knsalvador/CMSC190_KANSalvador/INSTALL.md

# Installation
The apk file under the CMSC190_KANSalvador/code directory can be directly downloaded and installed on any android phone.

# Development Set-up
Include instructions how to setup development environment and include any prerequisites.
1. Arduino IDE 1.8.12 or higher and the following libraries:
  - Adafruit_NeoPixel.h
  - OneWire.h
  - DallasTemperature.h
  - SoftwareSerial.h
  - FirebaseESP8266.h
  - ESP8266WiFi.h
  - SoftwareSerial.h

2. Android Studio 3.6.2 or higher

3. Google Firebase Realtime Database
