knsalvador/CMSC190_KANSalvador/presentation/CMSC190_KANSalvador_journal.pdf

CMSC 190 SPECIAL PROBLEM, INSTITUTE OF COMPUTER SCIENCE | 1

# Nemo: An Arduino Aquarium Monitoring System Controlled by An Android Mobile Application

Katrina Anne N. Salvador and Prof. Jaime M. Samaniego

Abstract—The growing popularity of mobile applications comes from its ability to assist in a wide range of tasks and its portability. This study aims to create an aquarium monitoring system that is manageable, cost-efficient, and relevant. This study utilizes the customizability of Arduino microcontrollers, along with compatible sensors, to measure water temperature, water pH, and water turbidity. A mobile application is created to alert the user when the condition of the aquarium is not ideal, display the data from the sensors that are retrieved from a Firebase realtime database where the data is uploaded by the Arduino, and allow the user to control the aquarium’s lighting supply.

I. INTRODUCTION
A. Background of the Study

The evolution of the basic mobile phone into smartphones that offer extensive capabilities and features made way to the first mobile applications. More specifically, the release of Apple’s first iPhone in 2007 worked up the acceleration of mobile applications that they boast as a new service type that meet the needs of users - ”Whatever you want to do, there is an app for it”. [15] From being used only for calling and texting, mobile phones have progressed into tools that support a wide variety of tasks such as music and movie streaming, online multiplayer gaming, navigating, travelling, reading news, etc. [2] These mobile applications have different kinds of users, some are large industries that take advantage of these capabilities and incorporate mobile apps into their businesses, and some people use these mobile applications personally for their own hobbies such as stargazing, gardening, and maintaining an aquarium.
Understanding what happens inside your aquarium is important in ensuring that aquatic life remains healthy. In maintaining an aquarium, monitoring is usually done manually. A human may commit errors due to nature. Gathering data about the aquarium’s current state must be done regularly and the user must be immediately alerted when problems arise [9]. Drastic changes in the levels of water parameter values affect the life of aquatic animals. With the help of sensors and wireless technology, a system that is simple but is effective in terms of minimizing overall human work and error, would provide great assistance.
B. Statement of the Problem

Most elements dissolve in water and it becomes hard to determine the amount of material mixed in it. Checking the quality of water requires accuracy and hard work. It has become necessary to involve technology to produce a quick result from an efficient method to determine the quality of water [13].
Fish are usually delicate to changes in its surroundings and pollution or conditions that are not suitable for fishkeeping may lead to a high mortality rate.
Currently, there are already several existing aquarium monitoring systems available on the market and over the internet such as, multifunctional aquariums which have built-in controllers that are able to adjust water level, temperature level, oxygen level, etc., or other mobile applications, but these can be very complex and expensive [6].
C. Objectives of the Study

This study aims to create an Android application and an Arduino-based system that will be able to digitally monitor a freshwater aquarium using sensors and actuators. More specifically, the proposed application aims to perform the following:
A) To obtain data regarding the aquarium’s current condition using sensors;
B) To be able to switch the aquarium LED using the application over WiFi;
C) To be able to display the aquarium’s current conditions on a mobile application; and
D) To be able to notify the user regarding unacceptable changes in the aquarium’s condition.
D. Scopes and Limitations of the Study

This study will be limited to small-scale home freshwater aquariums containing common tropical fish. The parameters that will be measured are:
A) Water temperature
B) Water pH
C) Water turbidity
The aquarium component that will use an actuator is:
A) LED
The mobile application was developed by the researcher herself and will not be uploaded to the Google Play Store. The accuracy of the data is dependent on the specifications of each sensor.
Arduino clones will be used for prototyping.
Due to the ongoing quarantines caused by the COVID-19 pandemic, an actual aquarium is not available for testing which involves physical contact. Instead, a 500ml sample of water from the aquarium is obtained for testing.

E. Significance of the Study

With the evolution of technology, more and more tasks become easier to complete because almost everything can be done with the help of mobile applications.
With the use of a mobile application and an internet connection, a user will be able to know the current state of his/her aquarium without personally assessing and measuring the water’s condition. When this system is implemented on a large scale, it may be used in monitoring the water quality of fish farms.

II. REVIEW OF RELATED LITERATURE

A. Ideal Aquarium Condition Parameters

For a freshwater aquarium, the ideal measurement of water temperature falls within the range of 22.22-27.77◦C and the ideal level of water pH falls within the range of 6.5-7.5 [7]. Most, but not all, species of tropical or freshwater fish can thrive on the mentioned pH levels. This is the reason behind why some fish are usually kept separate in different tanks with different pH levels. The safe turbidity level for long-term exposure is up to 3 NTU and fish begin to show signs of stress at 10 NTU. [11]
It is vital to monitor the temperature of your aquarium’s water. For tropical fish, heat is necessary during the colder months of the year. Many aquarists living in places with temperate climates face the opposite problem during summer, which is, keeping the aquarium from overheating [8].
As the water’s pH increases, so does the ammonia percentage. Ammonia is toxic and at high pH levels, it limits an organism’s ability to purge itself of waste. Keeping your aquarium pH stable not only reduces stress on the fish, helps them resist disease and tolerate stressors but can also dramatically improve growth, behavior, and overall appearance [3].
Another measure of water quality is turbidity. It is the cloudiness or haziness of a fluid caused by a multiplicity of individual particles that are generally invisible to the naked eye, similar to smoke in air. It is basically an optical determination of water clarity. Turbidites may appear in the form of milky-gray water or as a greenish stain in the water. Milky or green stains indicate an algal or bacterial bloom. This phenomenon can happen quite suddenly and be caused by fluctuations in seasons [16].
The species that inhabit aquariums will be impacted in varying degrees by a constant level of light. To mimic the light available in a species’ habitat, aquarium owners can use day and night lighting to approximate the light levels in a natural environment. These night lights, or Moon Lights, as they are called, give the fish keeper the opportunity to observe nocturnal behavior. [17] Bright light also helps enrich the color of the fish. Bright light helps darken the pigments of many fish, making them stand out.
Lighting is a major part of having a visually pleasing community aquarium. The right lighting is very beneficial to aquatic plant life and therefore, to the fish and aquatic creatures in the aquarium as well.
B. Internet of Things and Wireless Sensor Networks
The Internet of Things or what is more commonly known as IoT involves a network of physical devices embedded with electronics, sensors, and actuators which can collect, connect and exchange data with each other. Lately there has been considerable growth in the development of actuators and sensors [10]. A wide range of industries are giving IoT growing attention as technological and societal pressures call for their innovation. One of the essential IoT technologies which is the Wireless Sensor Network (WSN), is mostly used for maintenance and tracking systems. By analyzing data in real time, users such as companies save time and money involving preventive maintenance. [5]
C. Arduino
An Arduino is an open-source platform used for constructing and programming electronics. It can receive and send information and commands to most devices through the internet, a local network, a bluetooth connection, or simply through physical electrical connections. Today, Arduino microcontrollers are being used a lot in microcontroller programming because of its usability and affordability. An Arduino can help you read information from input devices such as sensors, antennas, and can also send information to output devices such as LED, Speakers, LCD Screen, or even a user-made mobile application [1]. Moreover, Arduino microcontrollers are known for their customizability wherein you can tailor almost all of the variables in a way that would perfectly cater your project.

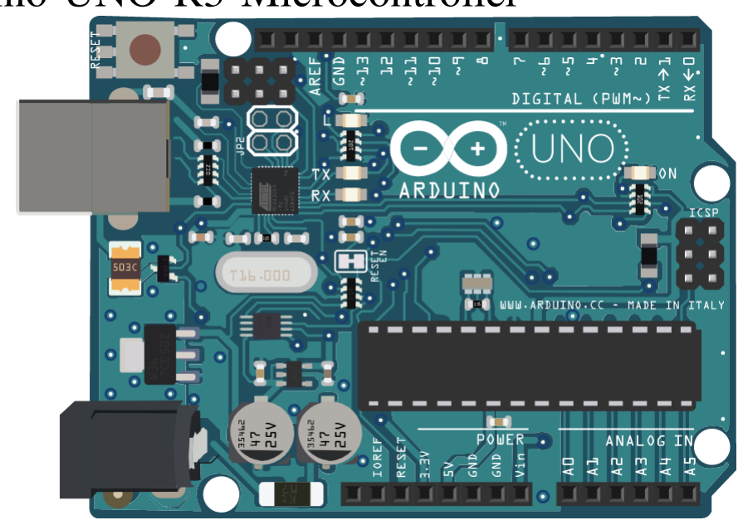
[picture p1: figure]

Fig. 1. An Arduino UNO R3 Microcontroller

D. Similar Studies
A study in 2017 by Shrenika tried to solve the problem of a water tank’s stainless steel water level sensors that get corroded by some chemicals. The researchers used Arduino, an Arduino-compatible ultrasonic sensor, and LabVIEW - a visual programming platform. The system had a big advantage compared to existing sensors in terms of data visualization and avoiding corrosion by using a non-contact sensor. It utilizes actuators as well for it can also switch on the pump when the water level is low and turn it off when the tank is already full. Another study by Singh and Saikia in 2016 is about an Arduino-Based Smart Irrigation System that monitors the temperature and moisture of the soil. The user can monitor the moisture and turn on water pumps through a button that is connected to the system. The amount of water from the water pump can also be measured through the use of a water flow sensor.
Just like this study, both studies mentioned earlier make use of Arduino microcontrollers, ESP8266 WiFi Module, sensors, and actuators. For experimental purposes, all studies are done in a small scale but can easily be expanded to be able to supply for larger projects or systems.

III. MATERIALS AND METHODS

A. Development Tools
1) Hardware:
A) 64-bit Laptop Computer running on 8GB RAM and Intel

R CoreTM i7 3670QM
B) Samsung Galaxy S10
C) Arduino UNO R3 CH340G SMD microcontroller
D) ESP8266 ESP-01 Arduino WiFi Module
E) DS18B20 Water Temperature Sensor; Range: -55◦C to +125◦C; Accuracy: ±0.5

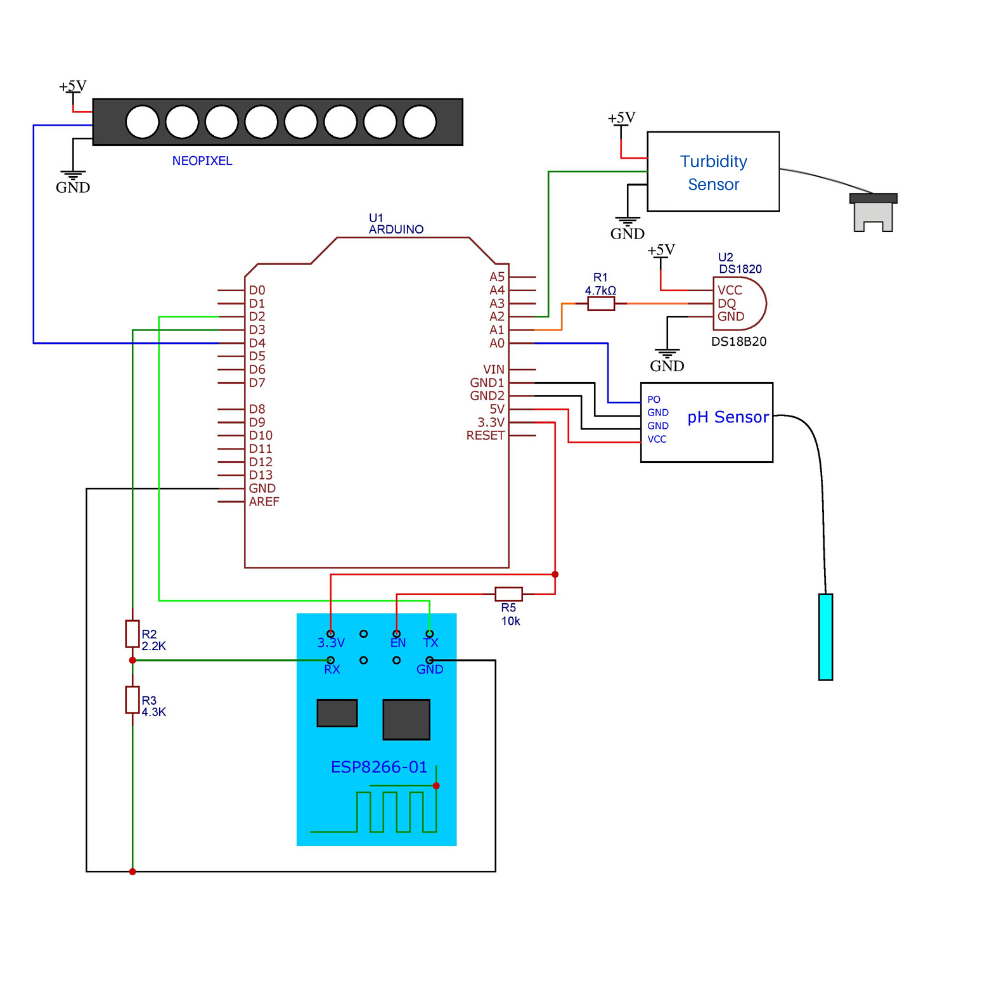
[picture p2: figure]

◦C
F) SEN0161 Gravity: Analog pH Sensor; Range: 0-14pH; Accuracy: ±0.1pH
G) SEN0189 Gravity: Arduino Turbidity Sensor
H) Arduino NeoPixel Stick - 8 x 5050 RGB LED
I) Breadboard
J) Jumper wires
K) 1% tolerance 1/4 watt resistors (2.2k, 4.3k, 4.7k, 10k ohms)
2) Software:
A) Windows 10 Operating System
B) Android Studio version 3.1.3
C) Arduino IDE 1.8.6
D) Android 10
E) Google Firebase Realtime Database
B. Methods
1) Hardware Assembly: The flow of the whole system follows the diagram in figure 2 wherein the sensors, the actuator, and the WiFi module are all physically connected to the microcontroller while it communicates with the app through the database and an internet connection.
For prototyping, the sensors and the actuator are connected to the controller using a breadboard that follows the schematic shown in figure 3 and implemented as shown in figure 4.
2) Database Setup: Google Firebase offers a realtime database that can communicate with the ESP8266 WiFi module and Android Studio, where the mobile app will be created. This database uses the JSON format. The database can handle multiple users for a single app but for the purpose of this study, the database can handle only one generic user. The database is set up by signing-in using a Gmail account and selecting the ”Realtime Database” option wherein some project details, such as the title and privacy settings, are needed. The privacy is set to public in order for the Arduino and the mobile app to be able to modify the contents of the database.

Fig. 2. Diagram of the system’s network

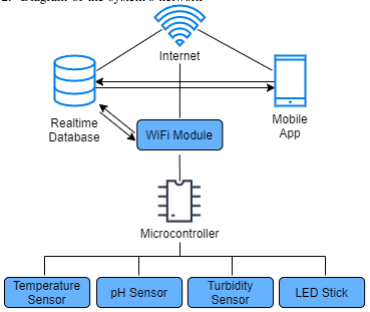
[picture p3: figure]

Fig. 3. Nemo electronic circuit schematic

3) ESP8266 WiFi Module Initialization: Since the ESP8266 WiFi Module is also a microcontroller, it is capable of storing and running a code separately from the Arduino Uno. It doesn’t have a USB port so the Arduino Uno was used as an adapter to upload programs to the WiFi Module. The code for the WiFi Module includes the credentials (SSID and password) of the network to be used by the Arduino Uno, the database’s unique url, and the database’s provided authentication key. The code for the WiFi module also contains the algorithm of the formatting of data from the Arduino Uno to be sent to the database and vice-versa.
4) Data Gathering: The temperature sensor reads and returns the temperature as it is but the pH sensor and turbidity sensor return voltage values that need to be converted to either NTU or pH value. The readings from the sensors fluctuate due to the noise from the voltage line and the signal line so

Fig. 4. Nemo prototype

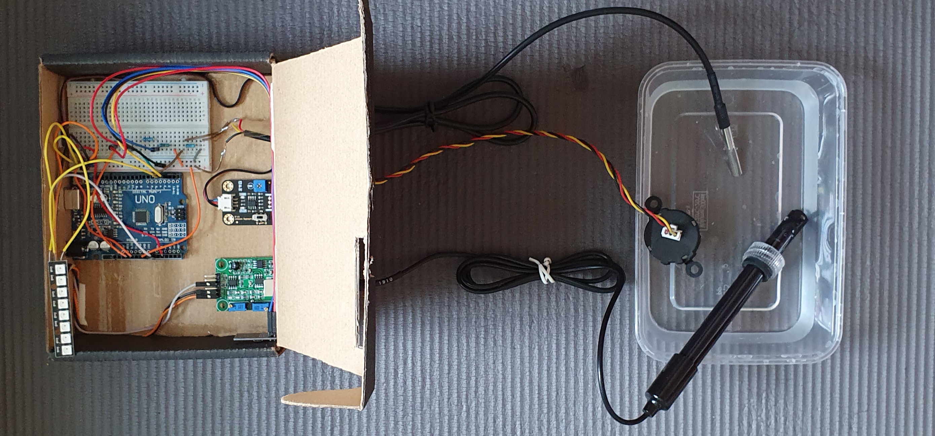
[picture p4: figure]
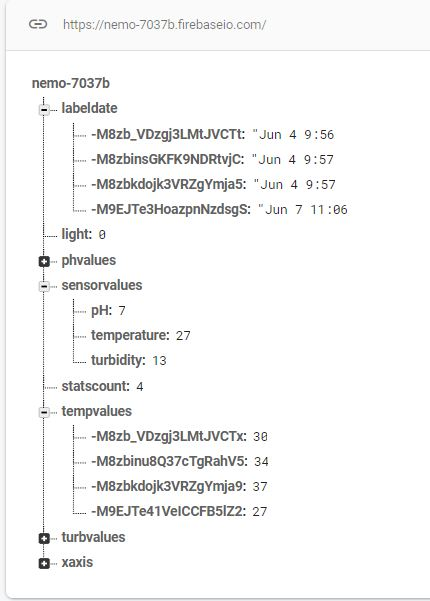
[picture p5: figure]

Fig. 5. Contents of the database

they need to be averaged first before being converted to the corresponding unit. The pH sensor and turbidity sensor need to be calibrated first using buffer solutions. Calibration is done only once. Buffer solutions have fixed values that are used to map voltage to the values in order to come up with a formula for the conversion. The pH sensor returned a reading of 551.0 for 7.00 pH and 657 for 4.02 pH. Since the two pairs of values can function as coordinates ((551, 7) and (657, 4.02)), when each point is plotted and connected, they form a straight line. The equation of that line will be able to tell the corresponding pH value for any sensor reading that falls on the length of the line. The equation of any straight line is y = mx + b wherein x is the sensor reading and y is the corresponding pH value. m and b are derived using the values from the buffer solution.

m = (4.02 − 7)/(657 − 551) = −0.0281

b = |(−0.0281 ∗ 551) − 7| = 22.4831

The main conversion formula for the pH sensor is:

y = (−0.0281 ∗ sensorReading) + 22.4831

The turbidity sensor returned a reading of 900 for 1 NTU and 693 for 15 NTU. Following the same steps from the pH sensor, m and b are derived using these values.

m = (1 − 15)/(900 − 693) = −0.0676

b = |(−0.0676 ∗ 693) − 15| = 61.8468

The main conversion formula for the turbidity sensor is:

y = (−0.0676 ∗ sensorReading) + 61.8468

The code containing these conversions also include the command that is able to switch the LED on or off and the function that can get the status of the LED.
5) Data Analysis: Data that are collected from the sensors at the controller are compared with the threshold parameter values. Table 1 shows the range of the values that are considered as safe and ideal for the fish.

TABLE I
THRESHOLD VALUES
pH | Temperature | Turbidity
pH | Celsius | NTU
6.5 - 7.5 | 22.22 - 27.77 | 0 - 10
6) Data Transformation on the Mobile Application: The mobile app was created using Android Studio. The app has 2 activities, the dashboard and the history. Firebase’s library is used in order to communicate easily with the data from the database. The dashboard displays the values from each sensor, which are retrieved from the database, along with a gauge for easier visual interpretation. There is also a card that displays the status of the LED and a button that serves as a light switch. On this activity, the user can save the currently displayed values and it will be saved on the history page where there are 3 line graphs, one for each component of the water quality. With the line graph, the user can easily compare trends among the saved data. The current date and time are saved and displayed along with the data. The user can also clear the contents of the history. When the values in the dashboard reaches a certain threshold set earlier, it notifies the user about which component needs attention.

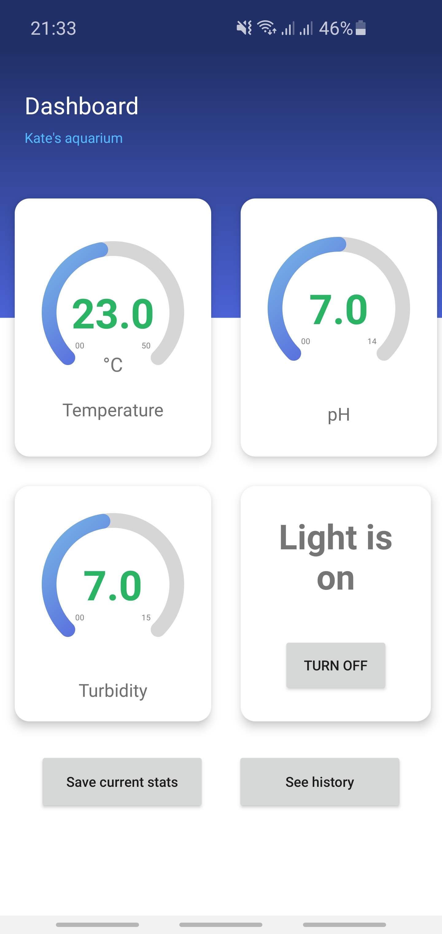
[picture p6: figure]

Fig. 6. Dashboard

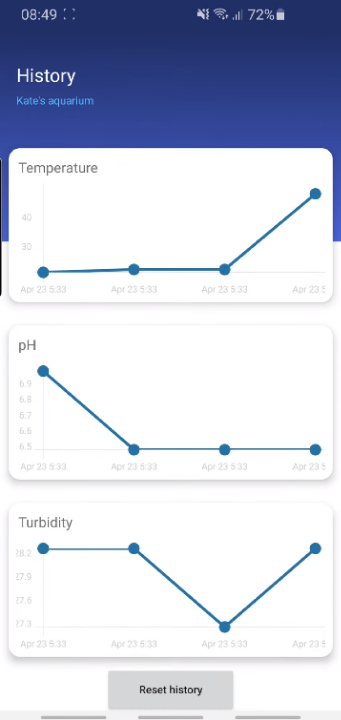
[picture p7: figure]

Fig. 7. History

IV. RESULTS AND DISCUSSION

When turning on or restarting the Arduino, the mobile application needs to be closed and opened only after the Arduino has connected to the internet. This is done in order for the data to load properly on the mobile application given that it is connected to the internet. The Arduino and the mobile application don’t need to be connected to the same network to function, both just need to be connected to a network simultaneously.
Testing the system on water from an aquarium and on clean water yielded the appropriate corresponding values for temperature and pH but varied on the turbidity level. Since the turbidity sensor uses light transmittance as a way to determine the cloudiness, the most accurate readings of turbidity are produced from a well-lit aquarium.
The mobile application has also successfully notified the user about which component needs attention. That particular component’s value on the dashboard is also displayed in red or yellow instead of green to indicate that it is not ideal for the fish.
V. CONCLUSION AND FUTURE WORK
The use of the mobile application has helped in minimizing the time of monitoring the aquarium, specifically its water quality, compared to using separate complex materials that individually measure each component, manually recording the data and manually referring to the ideal values.
When implemented on a larger scale, this system can be used on fish farms, rivers, aquaculture, rehabilitation sanctuaries for endangered aquatic animals that need constant monitoring and have strict environment requirements, etc. For a large-scale implementation, this system is comparatively a cost-efficient investment. The Arduino-based system upheld its ease of implementation, operation, maintenance and cost. The availability of an internet connection is limited in certain places. The implementation or addition of an SMS notification system may be done by using an Arduino GSM shield in order to allow the Arduino send and receive messages. The vast use of mobile applications is a big advantage to interdisciplinary fields. Technology is continuously evolving and is reaching more disciplines which means there are still a lot of helpful and useful breakthroughs to be discovered as we continue to study the different possibilities in using mobile applications.

REFERENCES

[1] Badamasi, Y. A. (2014). The working principle of an Arduino. 2014 11th International Conference on Electronics, Computer and Computation (ICECCO). doi:10.1109/icecco.2014.6997578
[2] Bohmer, M., Hecht, B., Sch ¨ | | | oning, J., Kr ¨ | uger, A., Bauer, G. (2011). ¨
Falling asleep with Angry Birds, Facebook and Kindle. Proceedings of the 13th International Conference on Human Computer Interaction with Mobile Devices and Services - MobileHCI 11. doi: 10.1145/2037373.2037383
[3] Costa, K. (n.d.). Why Testing Aquarium pH is Important. Retrieved from http://blog.hannainst.com/aquarium-ph
[4] Ieee Internet Of Things Journal, Vol. 3, No. 1, February 2016,70-95
[5] Lee, I., Lee, K. (2015). The Internet of Things (IoT): Applications, investments, and challenges for enterprises. Business Horizons, 58(4), 431–440. doi: 10.1016/j.bushor.2015.03.008
[6] Ma, Y., & Ding, W. (2014). Design and Implementation of Aquarium Remote Automation Monitoring and Control System. Computer and Computing Technologies in Agriculture VII IFIP Advances in Information and Communication Technology,102-108. doi:10.1007/978-3-642-54344-9 12
[7] Maintaining Proper Water Quality in the Home Aquarium. (n.d.). Retrieved from https://m.liveaquaria.com/article/89/?aid=89
[8] Pint. | [. | (n.d.). | Temperature | Control. | Retrieved | from
http://www.tfhmagazine.com/aquarium-basics/temperature-control.htm
[9] Rajesh, S., Jadhav, S., & Nehasingh. (n.d.). Ubiquitous Aquarium Management System. IOSR Journal of Computer Engineering (IOSR-JCE),1, 66-69.
[10] Razzaque, M. A., Milojevic-Jevric, M., Palade, A., & Clarke, S. (2016). Middleware for Internet of Things: A Survey. IEEE Internet of Things Journal,3(1), 70-95. doi:10.1109/jiot.2015.2498900
[11] Robertson-Bryan, Inc. technical memorandum: Suspended Solids and Turbidity Requirements of Freshwater Aquatic Life. (2006). Elk Grove, CA.

CMSC 190 SPECIAL PROBLEM, INSTITUTE OF COMPUTER SCIENCE

6

[12] Shrenika, R. M., Chikmath, S. S., Kumar, A. V. R., Divyashree, Y. V., Swamy, R. K. (2017). Non-contact Water Level Monitoring System Implemented Using LabVIEW and Arduino. 2017 International Conference on Recent Advances in Electronics and Communication Technology (ICRAECT). doi: 10.1109/icraect.2017.51
[13] Sigdel, B. (2017). Helsinki Metropolia University of Applied Sciences Water Quality Measuring Station.
[14] Singh, P., Saikia, S. (2016). Arduino-based smart irrigation using water flow sensor, soil moisture sensor, temperature sensor and ESP8266 WiFi module. 2016 IEEE Region 10 Humanitarian Technology Conference (R10-HTC). doi: 10.1109/r10-htc.2016.7906792
[15] Wang, H.-Y., Liao, C., Yang, L.-H. (2013). What Affects Mobile Application Use? The Roles of Consumption Values. International Journal of Marketing Studies, 5(2). doi: 10.5539/ijms.v5n2p11
[16] Water | turbidities | in | the | aquarium. | (n.d.). | Retrieved | from
https://www.aquasabi.com/aquascaping-wiki/aquarium/cloudy-water
[17] Which Lighting Is Best for a Well-Planted Community Aquarium? (n.d.). Retrieved from https://www.thesprucepets.com/understandingfreshwater-aquarium-lighting-4082719
[18] (n.d.). Retrieved from https://www.quora.com/Why-is-the-water-levelin-my-fish-tank-decreasing-slowly-There-is-no-leak-in-the-tank-whichis-a-15-gallon-US-tank

# Image

Katrina Anne N. Salvador is an undergraduate from the Institute of Computer Science, University of the Philippines Los Banos. ˜
