knsalvador/CMSC190_KANSalvador/CHANGELOGS.md

# History of Enrollment
* [1, AY 2018-2019] - Enrolled CMSC 190-1 under JMSamaniego
* [1, AY 2019-2020] - Enrolled CMSC 190-2 under JMSamaniego
* [2, AY 2019-2020] - Completed CMSC 190
